michael-michelotti/ir-remote-fan/Img/IR_Remote_Schematic.png

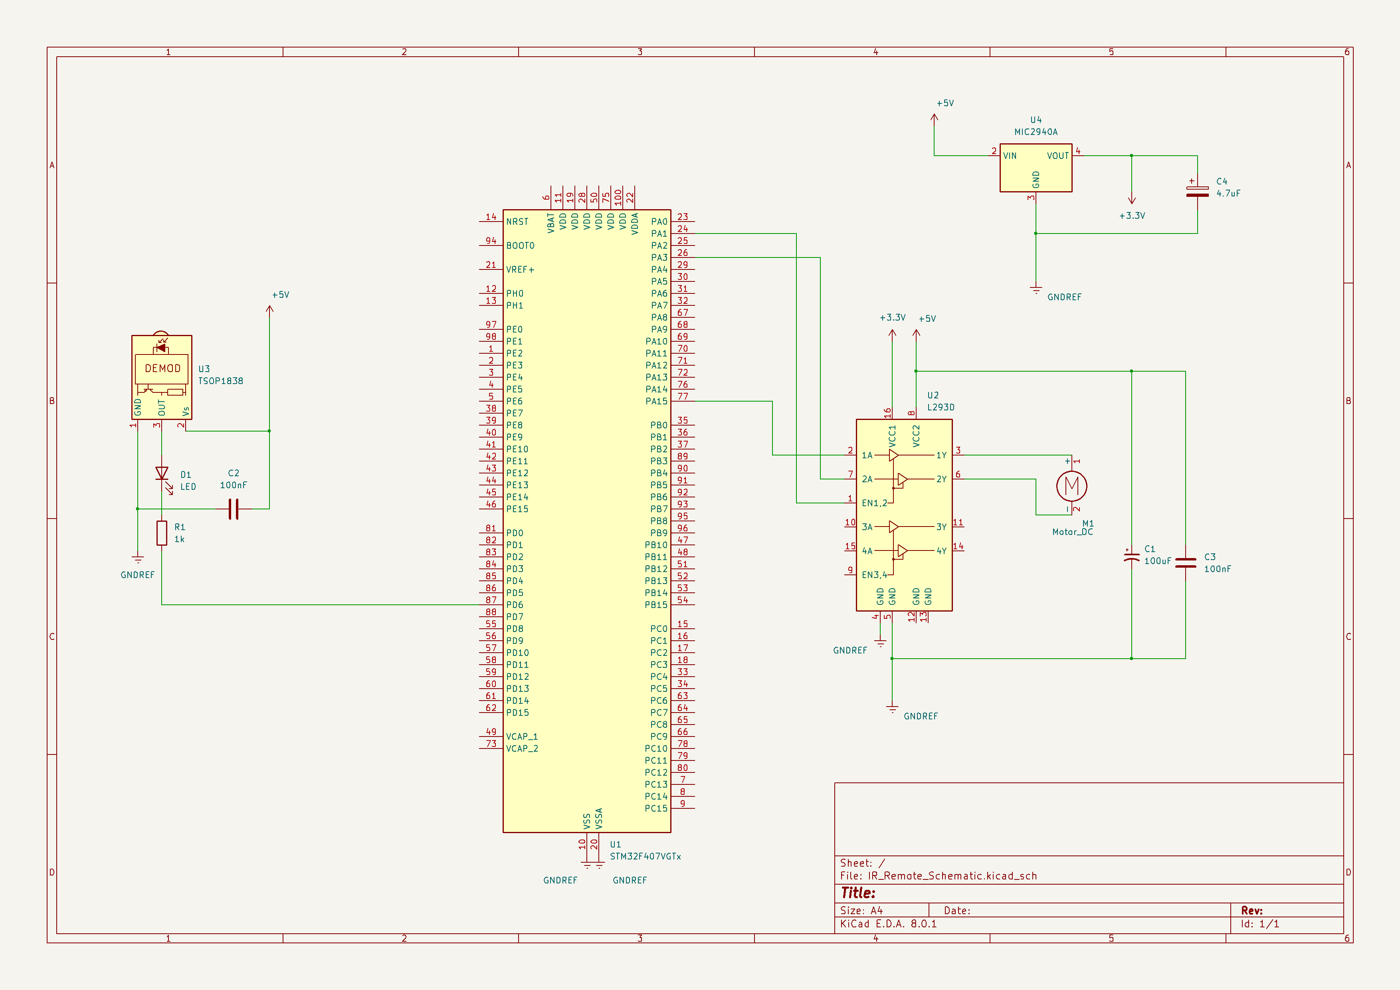
Img/IR_Remote_Schematic.png
