michael-michelotti/ir-remote-fan/Core/Src/main.c

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
/* Includes ------------------------------------------------------------------*/
#include "main.h"

/* USER CODE BEGIN Includes */
#include "remote.h"
#include "fan.h"

/* USER CODE END Includes */

TIM_HandleTypeDef htim2;
TIM_HandleTypeDef htim3;
TIM_HandleTypeDef htim5;

/* USER CODE BEGIN PV */
Remote_Device_t remote;
Fan_Device_t fan;

/* USER CODE END PV */

void SystemClock_Config(void);
static void MX_GPIO_Init(void);
static void MX_TIM2_Init(void);
static void MX_TIM5_Init(void);
static void MX_TIM3_Init(void);
/* USER CODE BEGIN 0 */

void Remote_Key_Press_Callback(char_code_t pressed_char)
{
	remote.last_char_code = pressed_char;
	remote.last_char_str = Remote_Decode_Char_Code(remote.last_char_code);

	switch (remote.last_char_code)
	{
	case CHAR_CODE_PWR:
		if (fan.state == FAN_STATE_OFF)
		{
			Fan_On(&fan);
		}
		else
		{
			Fan_Off(&fan);
		}
		break;
	case CHAR_CODE_0:
		Fan_Set_Speed(&fan, FAN_SPEED_0);
		break;
	case CHAR_CODE_1:
		Fan_Set_Speed(&fan, FAN_SPEED_1);
		break;
	case CHAR_CODE_2:
		Fan_Set_Speed(&fan, FAN_SPEED_2);
		break;
	case CHAR_CODE_3:
		Fan_Set_Speed(&fan, FAN_SPEED_3);
		break;
	case CHAR_CODE_4:
		Fan_Set_Speed(&fan, FAN_SPEED_4);
		break;
	case CHAR_CODE_5:
		Fan_Set_Speed(&fan, FAN_SPEED_5);
		break;
	case CHAR_CODE_6:
		Fan_Set_Speed(&fan, FAN_SPEED_6);
		break;
	case CHAR_CODE_7:
		Fan_Set_Speed(&fan, FAN_SPEED_7);
		break;
	case CHAR_CODE_8:
		Fan_Set_Speed(&fan, FAN_SPEED_8);
		break;
	case CHAR_CODE_9:
		Fan_Set_Speed(&fan, FAN_SPEED_9);
		break;
	}
}

void Remote_Key_Hold_Callback()
{
}

/* USER CODE END 0 */

/**
  * @brief  The application entry point.
  * @retval int
  */
int main(void)
{

  /* MCU Configuration--------------------------------------------------------*/

  /* Reset of all peripherals, Initializes the Flash interface and the Systick. */
  HAL_Init();

  /* Configure the system clock */
  SystemClock_Config();

  /* Initialize all configured peripherals */
  MX_GPIO_Init();
  MX_TIM2_Init();
  MX_TIM5_Init();
  MX_TIM3_Init();
  /* USER CODE BEGIN 2 */

  Remote_Listen(&remote);
  Fan_Initialize(&fan);

  /* USER CODE END 2 */

  /* Infinite loop */
  /* USER CODE BEGIN WHILE */
  while (1)
  {
    /* USER CODE END WHILE */

    /* USER CODE BEGIN 3 */
  }
  /* USER CODE END 3 */
}

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
