michael-michelotti/ir-remote-fan/(commit log)

2024-03-14 initial generation of mx cube code with timer2 generating pwm
2024-03-15 implement l293d driver, test driver in main function
2024-03-17 complete implementation of NEC decode logic, create initial files for remote driver implementation
2024-03-17 implement remote driver, create files for fan driver
2024-03-17 complete basic implementation of setting fan speeds
2024-03-17 refactor code to have drivers always take pointers, declare devices in consumer source files, and only expose remote and fan drivers to application code
2024-03-21 update fan pwm frequency to test noise response
    [ir-remote-fan.ioc, main.c]
2024-03-21 initial readme for ir remote fan
2024-03-21 add schematic image
2024-03-21 update readme with schematic image
